cgrgncu/ADS1256_NCU_V0_9C/GingerLily/README.md

# 野薑花 - 地球物理專用紀錄器 (Ginger Lily - Geophysical Recorder)
+ 野薑花象徵著信賴，這個紀錄器最大的理念就是要值得信賴。

### 型號(Model Name)
+ GLGR-8U8D-100
  + GLGR = Ginger Lily - Geophysical Recorder = 野薑花-地球物理專用紀錄器
  + 8U = 8 Units = 8個獨立ADC晶片
  + 8D = 8 Differential Inputs = 共有8個差動輸入
  + 100 = 100[SPS] = 取樣率100[Hz]
  + PCBA: ADS1256-M487-V09C
  + 尺寸: 待測
