cgrgncu/ADS1256_NCU_V0_9C/GingerLily/GLGR-8U8D-100/README.md

# GLGR-8U8D-100
+ GLGR = Ginger Lily - Geophysical Recorder = 野薑花-地球物理專用紀錄器
+ 8U = 8 Units = 8個獨立ADC晶片
+ 8D = 8 Differential Inputs = 共有8個差動輸入
+ 100 = 100[SPS] = 取樣率100[Hz]
+ PCBA: ADS1256-M487-V09C

### 更新紀錄
+ 2023-02-18，初版。

### 注意事項
+ 每個操作耗時不同，受限ADS1256特性，須盡量配合ADS1256的可操作時間。
+ M487使用時脈192[MHz]，理論上每個指令耗時0.00521[us]=5.21[ns]。
+ M487提供的內部函數會盡可能逼近提供一個1[us]的延遲。
+ UART若使用鮑率921600[bits/s]，理論上每個bit耗時1.085[us]，實際上有可能多達10.85[us]。
+ SPI若使用1.92[MHz]，理論上每個指令耗時=0.521[us]。
+ ADS1256的RDY在資料更新時會被拉HIGH，這個行為在SCLK=1.92[MHz]時，耗時最少4個週期=2.084[us]。
  + 在這2.084[us]的時間內操作的話會讀不到正確數值。
  + 以最高資料率30000SPS的狀況來看，每33.3333[us]會更新一筆資料，更新耗時2.084[us]，只剩下接下來的31.2493[us]可以讀取資料。

### 工作流程
+ 初始化:
  1. 上電。SD卡槽旁邊的LED燈(SD_POWER1)會亮。這是硬體過電就亮，非韌體控制。
      + 燒錄器可能會漏電使這個LED燈微亮。此時微亮表示供電不足，將無法正常運作。請確定5[V]0.5[A]電源存在。
  2. 初始化: 啟用Debug。
      + 使用鮑率=921600。
  3. 初始化: 啟用LED燈(紅黃綠)並測試。只能從外部觀看閃爍情況來驗證是否正常，軟體無法驗證。
      + 三個燈全亮500[ms]，接著全滅500[ms]，共計亮滅3次。
  4. 初始化: 啟用網路功能。包含設定MAC、IP、PORT等等。後續部分資訊同步從網路丟出。只能從外部Ping或UDP封包來驗證，無法自行驗證。
      + 三個燈全亮，表示開始啟用網路功能。
      + 網路參數:
        + MAC暫時都使用開發用MAC:「 02:00:00:00:00:00 」
        + 本機IP=192.168.10.11
        + 發送UDP封包的Src_Port=49152
        + 發送UDP封包的Dest_MAC=FF:FF:FF:FF:FF:FF
        + 發送UDP封包的Dest_IP=192.168.10.255
        + 發送UDP封包的Dest_Port=26100
        + 支援Ping功能，可用於驗證網路通暢。
      + 測試封包:
        + 送出一個回應本機IP位置的自訂命令UDP封包，長度固定為1024，沒用到的填0:
        ```
        {"From":"ADBoard","To":"All","By":"UDP","CMD":"ADBoardIP?","Return":"192.168.10.11"}
        ```
      + 三個燈全滅，表示完成啟用網路功能。延遲500[ms]後進入下一個初始化工作。
  5. 初始化: 啟用SD卡功能。包含檢查SD卡存在、SD卡資訊、建立資料夾、寫運行紀錄。後續有需要可再寫入新參數檔案。
      + 紅燈滅，黃綠燈亮，表示開始啟用SD卡功能
      + 紅燈滅，黃綠燈也滅，表示完成啟用SD卡功能。延遲500[ms]後進入下一個初始化工作。
      + 錯誤燈號: 紅燈恆亮，黃綠兩燈閃爍，間隔250[ms]。初始化工作會卡在這裡，無法繼續。
      + 在這個階段，寫入的檔案沒有正確時間資訊。
  6. 初始化: 啟用ADS1256。包含硬體RESET、SPI溝通等等。
  7. 初始化: 啟用GPS模組。包含UART、TP1、TP2。注意，GPS參數已由u-center預先設定好並儲存在GPS模組內部。
+ 主迴圈:
  1. 定義GPS時間索引。
    + 已規劃:TP1=1[Hz]，length=3000[us]；TP2=100[Hz]，length=5000[us]。
    + 準備好TP1與TP2的中斷。
    + 開啟GPS電源。
    + 
  +
