cgrgncu/ADS1256_NCU_V0_9C/8U8D_100_存檔格式.md

# 8U8D_100 存檔格式
+ 版本: v20230216a

### 更新紀錄
+ 2023-02-16，初版。

### 前言
+ JSON格式使用原則:
  + 考量嵌入式系統(嵌入式系統)韌體開發，使用精簡化的方案處理JSON資料，故限制可支援的JSON格式，以利開發與除錯。
  + 整個字串(左大括號到右大括號)的所有文字使用ASCII的可顯示字元。可顯示字元編號範圍是32-126（0x20-0x7E），共95個字元。換句話說，只可用英數字與符號，不可用中文。
  + 整個字串(左大括號到右大括號)的所有文字總長度上限1024個字元(小於或等於1024)。
  + 不允許嵌套(只使用單獨一層的JSON命令，只有一組大括號)。
  + 基本資料類型只使用字串(用雙引號包住的文字)。數值、布林值、陣列、物件、空值等，皆不允許使用。例如:
    + {"CMD":"Reboot"}
    + {"Time":"2023-02-16 16:25:00"}
    + {"Value":"123"}
    + {"Value":123} --> :x:數字型態不可使用
  + 描述與使用:
    + 在文件中的描述，有時為了美觀好讀JSON資料會利用換行、縮排的方式描述。
      ```
      {  
        "Latitude":"2504.15381 N",  
        "Longitude":"12137.35024 E"  
      }
      ```
    + 實際使用無換行無空格的最短形式。
      ```
      {"Latitude":"2504.15381 N","Longitude":"12137.35024 E"}
      ```
