cgrgncu/ADS1256_NCU_V0_9C/GingerLily/GLGR-8U8D-100/GLGR-8U8D-100存檔格式.md

# GLGR-8U8D-100 存檔格式
+ 版本: v20230216a

### 更新紀錄
+ 2023-02-16，初版。

### SD卡內的檔案結構
<table>
<tbody>
<tr>
<td colspan="19" width="431">
路徑
</td>
<td colspan="6" width="136">
說明
</td>
</tr>
<tr>
<td colspan="19" width="431">
X:\
</td>
<td colspan="6" width="136">
根目錄
</td>
</tr>
<tr>
<td width="22">
&nbsp;
</td>
<td colspan="18" width="409">
GLGR\
</td>
<td colspan="6" width="136">
紀錄器資料夾
</td>
</tr>
<tr>
<td width="22">
&nbsp;
</td>
<td width="22">
&nbsp;
</td>
<td colspan="17" width="386">
Data\
</td>
<td colspan="6" width="136">
Data資料夾
</td>
</tr>
<tr>
<td width="22">
&nbsp;
</td>
<td width="22">
&nbsp;
</td>
<td width="22">
&nbsp;
</td>
<td colspan="16" width="363">
202302\
</td>
<td colspan="6" width="136">
年月資料夾
</td>
<tr>
<td width="22">
&nbsp;
</td>
<td width="22">
&nbsp;
</td>
<td width="22">
&nbsp;
</td>
<td width="22">
&nbsp;
</td>
<td colspan="15" width="341">
A00120230214131530\
</td>
<td colspan="6" width="136">
<p>Record資料夾</p>
<p>*包含儀器四碼序號與起始時間</p>
</td>
</tr>
<tr>
<td width="22">
<p>&nbsp;</p>
</td>
<td width="22">
<p>&nbsp;</p>
</td>
<td width="22">
<p>&nbsp;</p>
</td>
<td width="22">
<p>&nbsp;</p>
</td>
<td width="22">
<p>&nbsp;</p>
</td>
<td colspan="14" width="319">
0001\
</td>
<td colspan="6" width="114">
分頁資料夾
</td>
</tr>
<tr>
<td width="22">
&nbsp;
</td>
<td width="22">
&nbsp;
</td>
<td width="22">
&nbsp;
</td>
<td width="22">
&nbsp;
</td>
<td width="22">
&nbsp;
</td>  
<td width="22">
&nbsp;
</td>
<td colspan="13" width="297">
0000000001.bin
</td>
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
</td>
<td width="22">
<p>&nbsp;</p>
</td>
<td width="22">
<p>&nbsp;</p>
</td>
<td width="22">
<p>&nbsp;</p>
</td>
<td width="22">
<p>&nbsp;</p>
</td>
<td width="22">
<p>&nbsp;</p>
</td>
<td width="22">
<p>&nbsp;</p>
</td>
<td width="22">
<p>&nbsp;</p>
</td>
<td width="22">
<p>&nbsp;</p>
</td>
<td width="22">
<p>&nbsp;</p>
</td>
<td width="22">
<p>&nbsp;</p>
</td>
<td width="22">&nbsp;</td>
</tr>
</tbody>
</table>

### SD 卡內的檔案系統結構項目說明
<table>
<tbody>
<tr>
<td width="200">
項目
</td>
<td width="200">
範例內容
</td>
<td width="267">
說明
</td>
</tr>
<tr>
<td width="200">
SD卡根目錄
</td>
<td width="200">
/
</td>
<td width="375">
&nbsp;
</td>
</tr>
<tr>
<td width="200">
紀錄器資料夾
</td>
<td width="200">
GLGR\
</td>
<td width="267">
<p>在 GLGR 產品中，一律使用此資料夾，以避免與其他產品混淆。</p>
<p>請確認SD卡沒有占用此資料夾。</p>
<p>請勿改動資料夾名稱大小寫。</p>
</td>
</tr>
<tr>
<td width="200">
Data資料夾
</td>
<td width="200">
Data\
</td>
<td width="267">
<p>在 GLGR 產品中，會存在一個子資料夾，名稱為「Data」，用來存放 Record 資料。</p>
<p>請勿改動資料夾名稱大小寫。</p>
</td>
</tr>
<tr>
<td width="200">
年月資料夾
</td>
<td width="200">
202302\
</td>
<td width="267">
依照年月來分類，避免太多Record資料夾。
</td>
</tr>
<tr>
<td width="200">
Record資料夾
</td>
<td width="200">
A00120230214131530\
</td>
<td width="267">
<p>開始進行一次量測時，將會提早創建一個Record資料夾。</p>
<p>這個資料夾名稱是獨一無二不會重複的，也代表一組獨立的量測記錄。</p>
<p>多次量測則有多個Record資料夾。</p>
<p>資料夾名稱命名規則:</p>
<p>作業系統序號後四碼+起始時間西元年月日時分秒(UTC 時間)</p>
<p>即「SXXXYYYYMMDDHHNNSS」</p>
<p>例如:「A00120230214131530」</p>
</td>
</tr>
<tr>
<td width="200">
分頁資料夾
</td>
<td width="200">
<p>0001\</p>
<p>0002\</p>
<p>...</p>
</td>
<td width="267">
<p>長期紀錄時檔案數量非常多，因此使用分頁資料夾來存放檔案，以避免開啟資料夾速度過慢。</p>
<p>資料夾名稱範圍: 1~9999(十進位範圍)或0x0001~0xFFFF(十六進位範圍)</p>
<p>*8u8D-100:每個分頁資料夾最多存放1440個檔案，採用1~9999(十進位範圍)。這表示最多可連續紀錄9999天(約27年多)。</p>
<p>*8u8D-100:每個資料檔案為1分鐘的資料，因此累積1440分鐘，也就是1天後，就會存放到第下個分頁資料夾中。</p>
</td>
</tr>
<tr>
<td width="200">
資料檔案
</td>
<td width="200">
<p>0000000001.bin</p>
<p>0000000002.bin</p>
<p>...</p>
</td>
<td width="267">
<p>GLGR產品的通用型資料檔案，副檔名為「.bin」。</p>
<p>*8u8D-100:單個資料檔案為8頻道，取樣率100[Hz]，1分鐘的資料。</p>
<p>檔案名稱範圍: 0~4294967295(對應uint32範圍)</p>
</td>
</tr>
<tr>
<td width="200">
Record組態檔
</td>
<td width="200">
Config.json
</td>
<td width="267">
<p>GLGR產品的通用型組態檔案，檔名為「Config.json」。</p>
<p>請勿改動檔案名稱大小寫。</p>
</td>
</tr>
</tbody>
</table>
