cgrgncu/ADS1256_NCU_V0_9C/GPS_Time_definition_8U8D.png

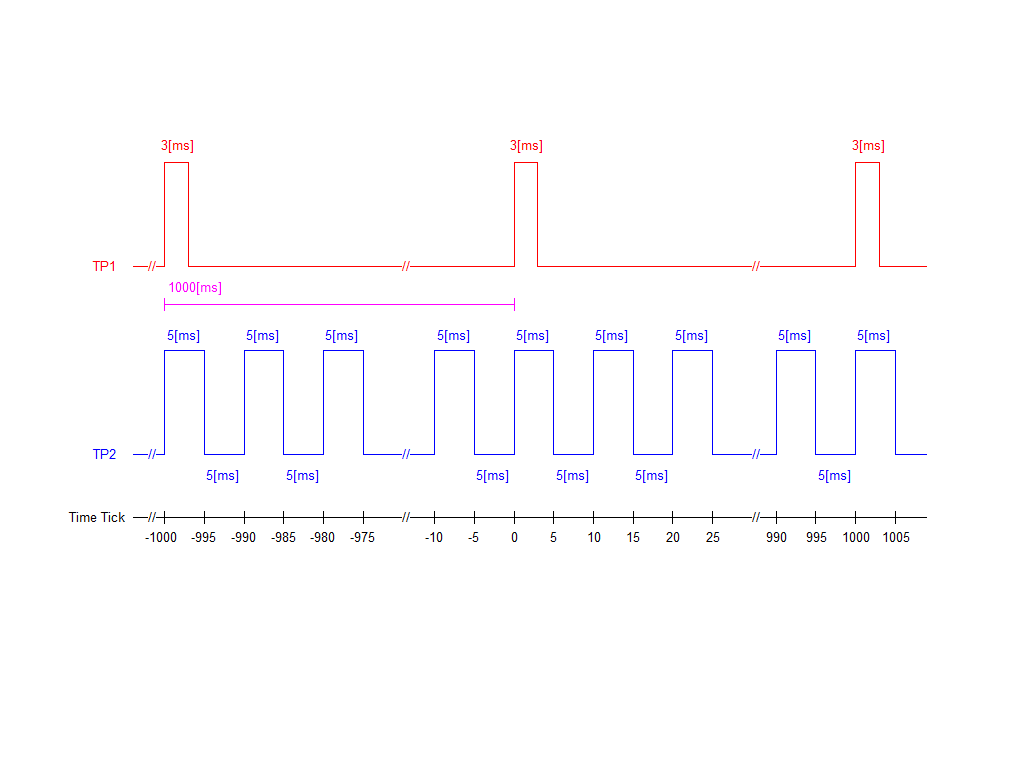
GPS_Time_definition_8U8D.png
