cgrgncu/ADS1256_NCU_V0_9C/NuMaker-PFM-M487/README.md

### NuMaker-PFM-M487
+ 目標產品是基於「NuMaker-PFM-M487」開發板所延伸開發出來的，因此大部分線路與韌體都從這裡開始開發測試。
