cgrgncu/ADS1256_NCU_V0_9C/NuMaker-PFM-M487/練習範例/YEH_LED_example_01/main.c

//**************************************************************************
//   Project: YEH_LED_example_01
//   File: main.c
//   Copyright: All rights reserved.
//   Author: HsiupoYeh 
//   Version: v20230122a
//   Description: 示範使用程式碼控制LED，記得需要手動增加stdDriver的gpio.c到Library中
//   REF:「..\M480BSP-3.05.001\SampleCode\Template」
//**************************************************************************

#include <stdio.h>
#include "NuMicro.h"

#define PLL_CLOCK           192000000

void SYS_Init(void)
{
    /*---------------------------------------------------------------------------------------------------------*/
    /* Init System Clock                                                                                       */
    /*---------------------------------------------------------------------------------------------------------*/
    /* Unlock protected registers */
    SYS_UnlockReg();

    /* Set XT1_OUT(PF.2) and XT1_IN(PF.3) to input mode */
    PF->MODE &= ~(GPIO_MODE_MODE2_Msk | GPIO_MODE_MODE3_Msk);

    /* Enable External XTAL (4~24 MHz) */
    CLK_EnableXtalRC(CLK_PWRCTL_HXTEN_Msk);

    /* Waiting for 12MHz clock ready */
    CLK_WaitClockReady(CLK_STATUS_HXTSTB_Msk);

    /* Set core clock as PLL_CLOCK from PLL */
    CLK_SetCoreClock(PLL_CLOCK);
    /* Set PCLK0/PCLK1 to HCLK/2 */
    CLK->PCLKDIV = (CLK_PCLKDIV_APB0DIV_DIV2 | CLK_PCLKDIV_APB1DIV_DIV2);

    //-----------------------------------------------
    // UART0的clock設定，這裡不必指定PIN腳
    //--
    /* Enable UART clock */
    CLK_EnableModuleClock(UART0_MODULE);
    /* Select UART clock source from HXT */
    CLK_SetModuleClock(UART0_MODULE, CLK_CLKSEL1_UART0SEL_HXT, CLK_CLKDIV0_UART0(1));
    //-----------------------------------------------

    /* Update System Core Clock */
    /* User can use SystemCoreClockUpdate() to calculate SystemCoreClock. */
    SystemCoreClockUpdate();

    //-----------------------------------------------
    // UART0的PIN腳GPIO設定。PB.12、PB.13連接到ICE，ICE提供UART轉USB功能
    //--
    /* Set GPB multi-function pins for UART0 RXD and TXD */
    SYS->GPB_MFPH &= ~(SYS_GPB_MFPH_PB12MFP_Msk | SYS_GPB_MFPH_PB13MFP_Msk);
    SYS->GPB_MFPH |= (SYS_GPB_MFPH_PB12MFP_UART0_RXD | SYS_GPB_MFPH_PB13MFP_UART0_TXD);
    //-----------------------------------------------

    /* Lock protected registers */
    SYS_LockReg();
}


int main()
{

    SYS_Init();
    /* Init UART to 57600-8n1 for print message */
    UART_Open(UART0, 57600);
    
    printf("\n");//第一行常有亂碼，先使用換行字元
    printf("*************************************\n");
    printf("* 韌體名稱: YEH_LED_example_01 \n");
    printf("* 版本: v20230122a \n");
    printf("*************************************\n");
    
    
    //=== GPIO pin37 (PH.0) - LED_R 
    // 初始化GPIO為輸出模式。找到LED_R對應的pin腳，依照其英文腳位名稱，PH.0。
    // 設定時對應輸入PH，BIT0
    GPIO_SetMode(PH, BIT0, GPIO_MODE_OUTPUT);
    // 這個腳位的輸出就是PH0，依照線路設計，GPIO低電位=0=ON，GPIO高電位=1=OFF。
    PH0=1;
    
    /* Got no where to go, just loop forever */
    while(1)
    {
      printf("\n");
      printf("請按下任意一個字元後紅色LED燈將亮起: \n");
      getchar();    
      PH0=0;
      printf("紅色LED燈恆亮!\n");
      
      printf("\n");
      printf("請按下任意一個字元後紅色LED燈將熄滅: \n");
      getchar();    
      PH0=1;
      printf("紅色LED燈恆滅!\n");
    };

}

/*** (C) COPYRIGHT 2016 Nuvoton Technology Corp. ***/
